EchelonForce/stm32f405_template_bob/README.md

# SMT32F405RG Template/BOB

This is a design for a STM32F405 based breakout board.

This work is licensed under a Creative Commons Attribution-NonCommercial-ShareAlike 4.0 International License. https://creativecommons.org/licenses/by-nc-sa/4.0/
