EchelonForce/stm32f405_template_bob/stm32f405_template/stm32f405_template_schematic.pdf

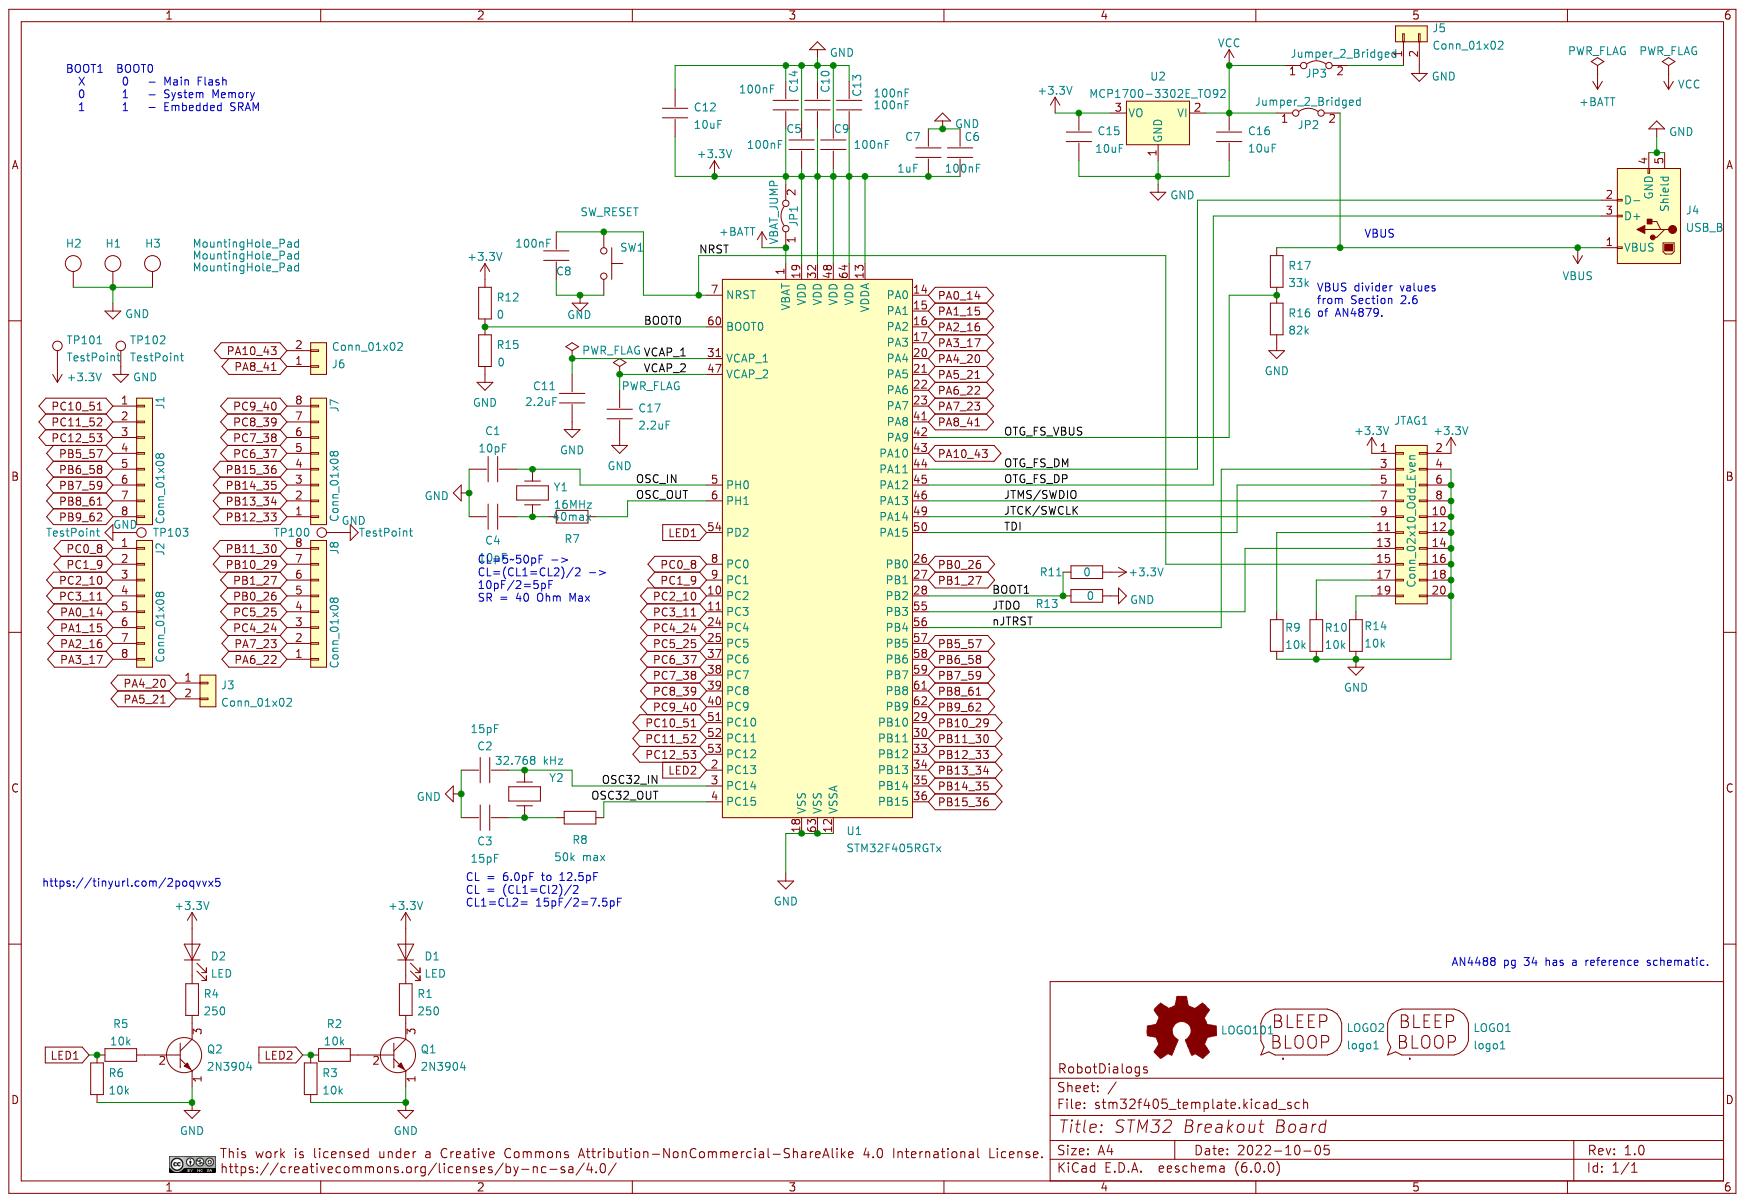
[picture p1: page 1]
