EchelonForce/stm32f405_template_bob/stm32f405_template/stm32f405_template.kicad_pcb

## KiCad design stm32f405_template/stm32f405_template.kicad_pcb (2023-01-16)

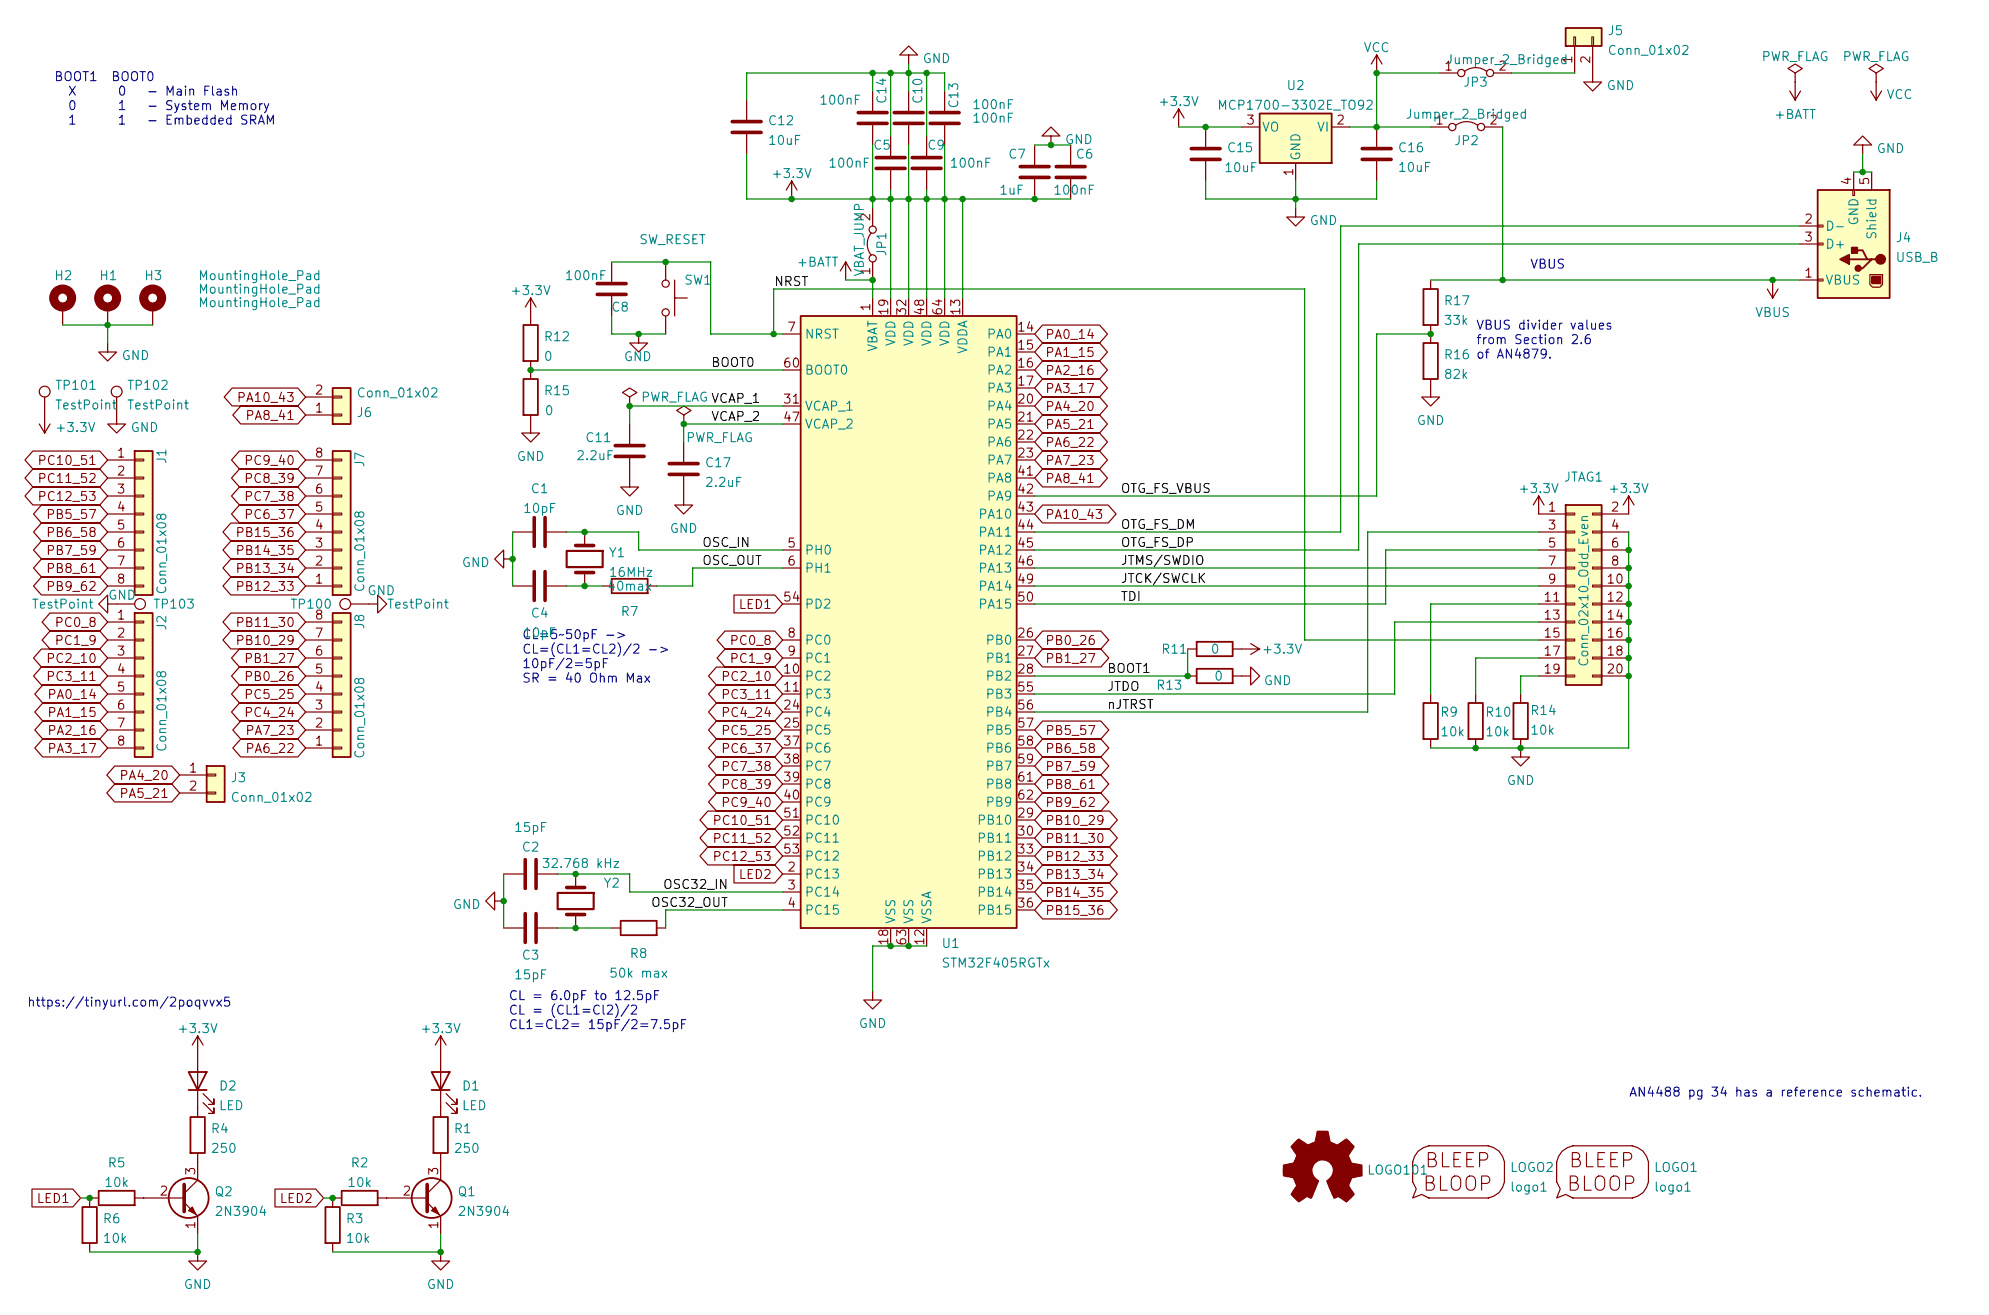
[picture p2: schematic stm32f405_template.kicad_sch, STM32 Breakout Board]

Parts:
C1, C4: 10pF; C_1206_3216Metric_Pad1.33x1.80mm_HandSolder
C2, C3: 15pF; C_1206_3216Metric_Pad1.33x1.80mm_HandSolder
C5, C6, C8, C9, C10, C13, C14: 100nF; C_1206_3216Metric_Pad1.33x1.80mm_HandSolder
C7: 1uF; C_1206_3216Metric_Pad1.33x1.80mm_HandSolder
C11, C17: 2.2uF; C_1206_3216Metric_Pad1.33x1.80mm_HandSolder
C12, C15, C16: 10uF; C_Disc_D5.0mm_W2.5mm_P5.00mm
D1, D2: LED; LED_D3.0mm
H1, H2, H3: MountingHole_Pad; MountingHole_3.2mm_M3_DIN965_Pad_TopBottom
J1, J2, J7, J8: Conn_01x08; PinHeader_1x08_P2.54mm_Vertical
J3, J5, J6: Conn_01x02; PinHeader_1x02_P2.54mm_Vertical
J4: USB_B; USB_Mini-B_Lumberg_2486_01_Horizontal
JP1: VBAT_JUMP; SolderJumper-2_P1.3mm_Bridged_Pad1.0x1.5mm
JP2, JP3: Jumper_2_Bridged; SolderJumper-2_P1.3mm_Bridged_RoundedPad1.0x1.5mm
JTAG1: Conn_02x10_Odd_Even; IDC-Header_2x10_P2.54mm_Vertical
LOGO1: logo1; OSHW-Symbol_6.7x6mm_SilkScreen
LOGO2: logo1; Logo1
LOGO101: Logo_Open_Hardware_Small; OSHW-Symbol_6.7x6mm_SilkScreen
Q1, Q2: 2N3904; TO-92_Inline_Wide
R1, R4: 250; R_1206_3216Metric_Pad1.30x1.75mm_HandSolder
R2, R3, R5, R6, R9, R10, R14: 10k; R_1206_3216Metric_Pad1.30x1.75mm_HandSolder
R7: 40max; R_1206_3216Metric_Pad1.30x1.75mm_HandSolder
R8: 50k max; R_1206_3216Metric_Pad1.30x1.75mm_HandSolder
R11, R12, R13, R15: 0; R_1206_3216Metric_Pad1.30x1.75mm_HandSolder
R16: 82k; R_1206_3216Metric_Pad1.30x1.75mm_HandSolder
R17: 33k; R_1206_3216Metric_Pad1.30x1.75mm_HandSolder
SW1: SW_RESET; SW_PUSH_6mm_H5mm
TP100, TP102, TP103: TestPoint; TestPoint_THTPad_1.5x1.5mm_Drill0.7mm
TP101: TestPoint; TestPoint_THTPad_D1.5mm_Drill0.7mm
U1: STM32F405RGTx; LQFP-64_10x10mm_P0.5mm
U2: MCP1700-3302E_TO92; TO-92_Inline_Wide
Y1: 16MHz; Crystal_HC49-4H_Vertical
Y2: 32.768 kHz; Crystal_C38-LF_D3.0mm_L8.0mm_Horizontal

Connections:
+3.3V: C5.1, C6.1, C7.2, C9.1, C10.1, C12.2, C13.1, C14.1, C15.1, D1.2 (A), D2.2 (A), JP1.2 (B), JTAG1.1, JTAG1.2, R11.1, R12.1, TP101.1, U1.13 (VDDA), U1.19 (VDD), U1.32 (VDD), U1.48 (VDD), U1.64 (VDD), U2.3 (VO)
+BATT: JP1.1 (A), U1.1 (VBAT)
/BOOT0: R12.2, R15.1, U1.60 (BOOT0)
/BOOT1: R11.2, R13.1, U1.28 (PB2)
/JTCK/SWCLK: JTAG1.9, U1.49 (PA14)
/JTDO: JTAG1.13, U1.55 (PB3)
/JTMS/SWDIO: JTAG1.7, U1.46 (PA13)
/NRST: C8.1, JTAG1.15, SW1.1, U1.7 (NRST)
/OSC32_IN: C2.2, U1.3 (PC14), Y2.1
/OSC32_OUT: R8.2, U1.4 (PC15)
/OSC_IN: C1.2, U1.5 (PH0), Y1.1
/OSC_OUT: R7.2, U1.6 (PH1)
/OTG_FS_DM: J4.2 (D-), U1.44 (PA11)
/OTG_FS_DP: J4.3 (D+), U1.45 (PA12)
/OTG_FS_VBUS: R16.1, R17.2, U1.42 (PA9)
/TDI: JTAG1.5, U1.50 (PA15)
/VCAP_1: C11.1, U1.31 (VCAP_1)
/VCAP_2: C17.1, U1.47 (VCAP_2)
/nJTRST: JTAG1.3, U1.56 (PB4)
GND: C1.1, C2.1, C3.1, C4.1, C5.2, C6.2, C7.1, C8.2, C9.2, C10.2, C11.2, C12.1, C13.2, C14.2, C15.2, C16.2, C17.2, H1.1, H2.1, H3.1, J4.4 (GND), J4.5 (Shield), J5.2, JTAG1.4, JTAG1.6, JTAG1.8, JTAG1.10, JTAG1.12, JTAG1.14, JTAG1.16, JTAG1.18, JTAG1.20, Q1.1 (E), Q2.1 (E), R3.2, R6.2, R9.2, R10.2, R13.2, R14.2, R15.2, R16.2, SW1.2, TP100.1, TP102.1, TP103.1, U1.12 (VSSA), U1.18 (VSS), U1.63 (VSS), U2.1 (GND)
LED1: R5.1, R6.1, U1.54 (PD2)
LED2: R2.1, R3.1, U1.2 (PC13)
unnamed: C3.2, R8.1, Y2.2
unnamed: C4.2, R7.1, Y1.2
unnamed: D1.1 (K), R1.1
unnamed: D2.1 (K), R4.1
unnamed: J5.1, JP3.2 (B)
unnamed: JTAG1.11, R9.1
unnamed: JTAG1.17, R10.1
unnamed: JTAG1.19, R14.1
unnamed: Q1.2 (B), R2.2
unnamed: Q1.3 (C), R1.2
unnamed: Q2.2 (B), R5.2
unnamed: Q2.3 (C), R4.2
PA0_14: J2.5, U1.14 (PA0)
PA1_15: J2.6, U1.15 (PA1)
PA2_16: J2.7, U1.16 (PA2)
PA3_17: J2.8, U1.17 (PA3)
PA4_20: J3.1, U1.20 (PA4)
PA5_21: J3.2, U1.21 (PA5)
PA6_22: J8.1, U1.22 (PA6)
PA7_23: J8.2, U1.23 (PA7)
PA8_41: J6.1, U1.41 (PA8)
PA10_43: J6.2, U1.43 (PA10)
PB0_26: J8.5, U1.26 (PB0)
PB1_27: J8.6, U1.27 (PB1)
PB5_57: J1.4, U1.57 (PB5)
PB6_58: J1.5, U1.58 (PB6)
PB7_59: J1.6, U1.59 (PB7)
PB8_61: J1.7, U1.61 (PB8)
PB9_62: J1.8, U1.62 (PB9)
PB10_29: J8.7, U1.29 (PB10)
PB11_30: J8.8, U1.30 (PB11)
PB12_33: J7.1, U1.33 (PB12)
PB13_34: J7.2, U1.34 (PB13)
PB14_35: J7.3, U1.35 (PB14)
PB15_36: J7.4, U1.36 (PB15)
PC0_8: J2.1, U1.8 (PC0)
PC1_9: J2.2, U1.9 (PC1)
PC2_10: J2.3, U1.10 (PC2)
PC3_11: J2.4, U1.11 (PC3)
PC4_24: J8.3, U1.24 (PC4)
PC5_25: J8.4, U1.25 (PC5)
PC6_37: J7.5, U1.37 (PC6)
PC7_38: J7.6, U1.38 (PC7)
PC8_39: J7.7, U1.39 (PC8)
PC9_40: J7.8, U1.40 (PC9)
PC10_51: J1.1, U1.51 (PC10)
PC11_52: J1.2, U1.52 (PC11)
PC12_53: J1.3, U1.53 (PC12)
VBUS: J4.1 (VBUS), JP2.2 (B), R17.1
VCC: C16.1, JP2.1 (A), JP3.1 (A), U2.2 (VI)

Notes on the sheet:
AN4488 pg 34 has a reference schematic.
BOOT1 BOOT0 X 0 - Main Flash 0 1 - System Memory 1 1 - Embedded SRAM
https://tinyurl.com/2poqvvx5
CL = 6.0pF to 12.5pF CL = (CL1=Cl2)/2 CL1=CL2= 15pF/2=7.5pF
VBUS divider values from Section 2.6 of AN4879.
VBUS
CL=5~50pF -> CL=(CL1=CL2)/2 -> 10pF/2=5pF SR = 40 Ohm Max

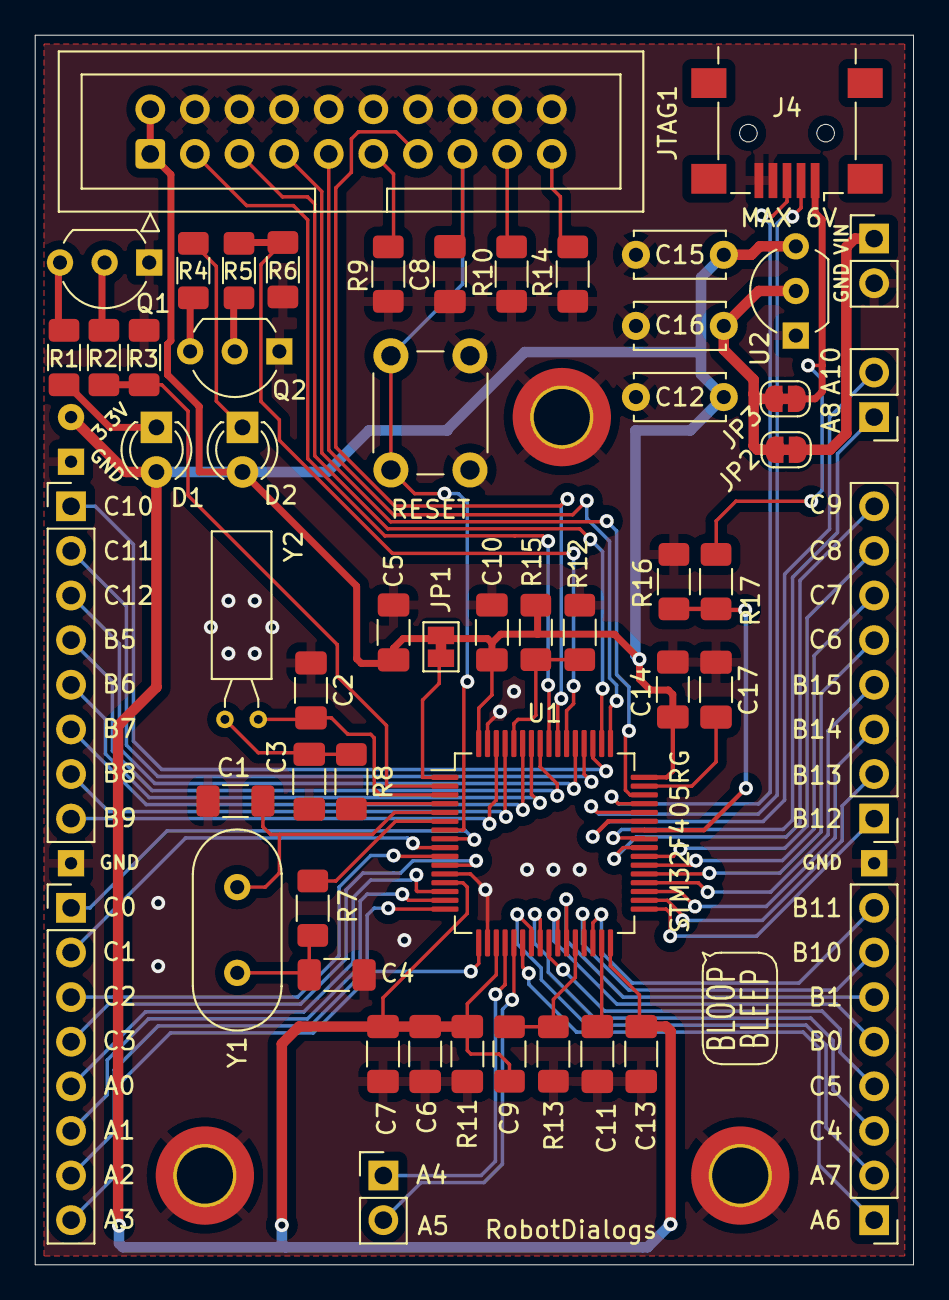
[picture p3: board stm32f405_template.kicad_pcb from above]

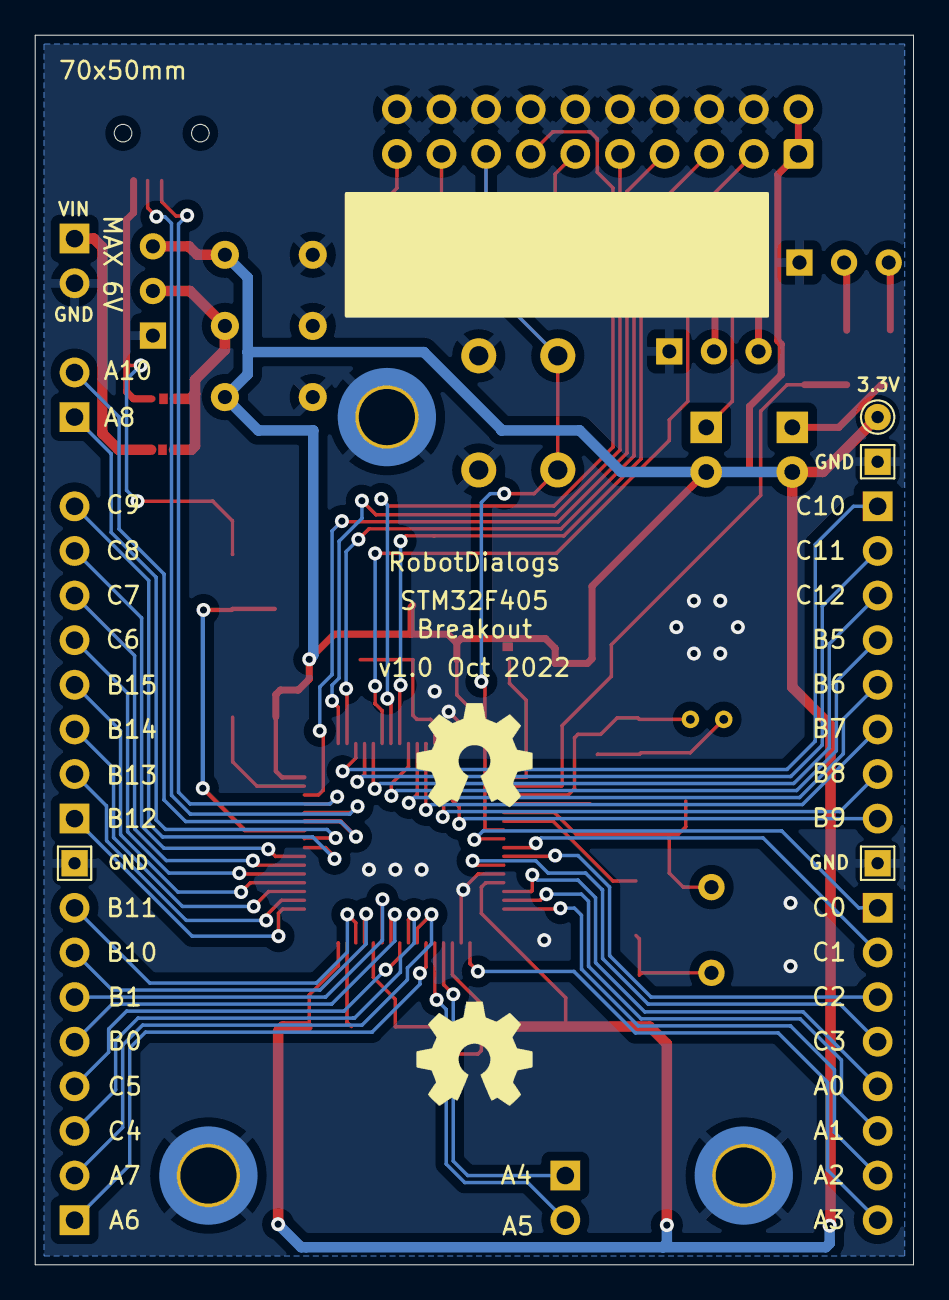
[picture p4: board stm32f405_template.kicad_pcb from below]

Board: 2 copper layers, 50.0 x 70.0 mm, 65 parts (6 on the bottom side), 72 nets.
