EchelonForce/stm32f405_template_bob/(commit log)

2022-10-04 Initial schematic and pcb layout and routing draft
    [stm32f405_template.kicad_pcb, stm32f405_template.kicad_sch]
2022-10-04 Geographic re-annotate and cleanup
    [stm32f405_template.kicad_pcb, stm32f405_template.kicad_sch]
2022-10-04 Silkscreen cleanup
    [stm32f405_template.kicad_pcb]
2022-10-10 Tidied silkscreen and some routing cleanup
    [stm32f405_template.kicad_pcb, stm32f405_template.kicad_sch]
2022-10-10 panelized v1
    [stm32f405_template_panelized.kicad_pcb]
2023-01-16 v1 schematic pdf with some assembly updates and notes
    [stm32f405_template.kicad_pcb, stm32f405_template.kicad_sch]
